AleksaBjelogrlic/glasgow_revD_io_wing/glasgow_revD_io_wing.pdf

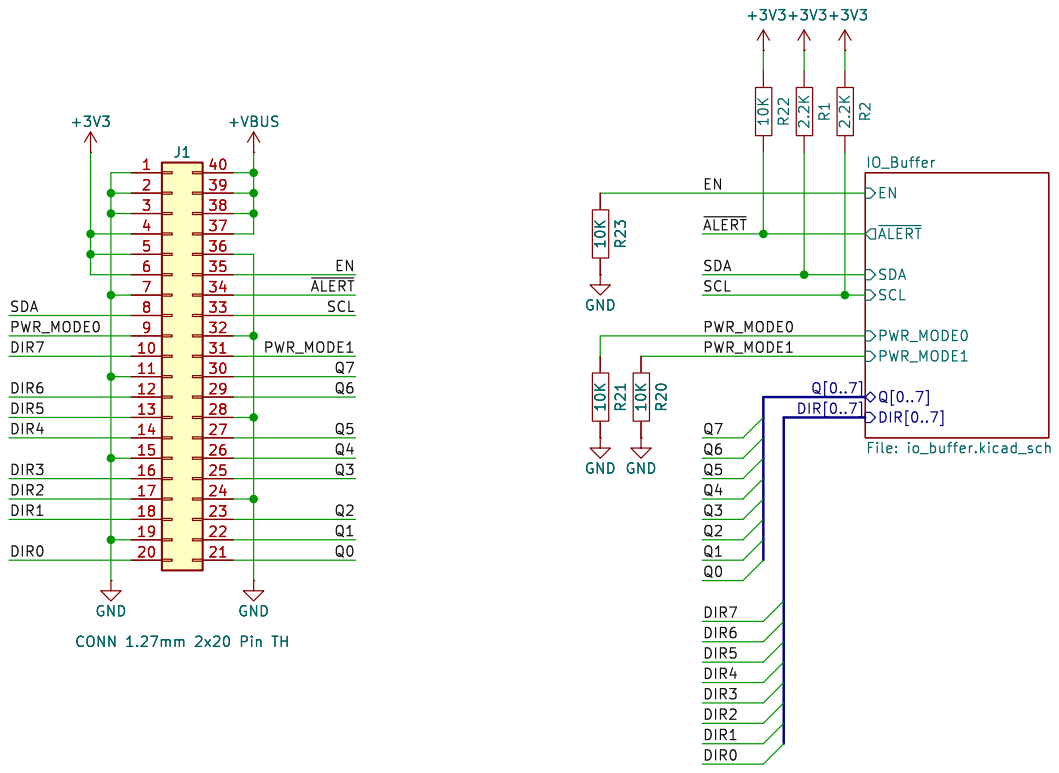
[picture p1: page 1]

2 2 | | 39 39
3 3 | | 38 38
4 4 | | 37 37
5 5 | | 36 36
6 6 | | 35 35 34 34 33 33 32 32

Id: 1/4 Title: File: glasgow_revD_io_wing.kicad_sch Sheet: /

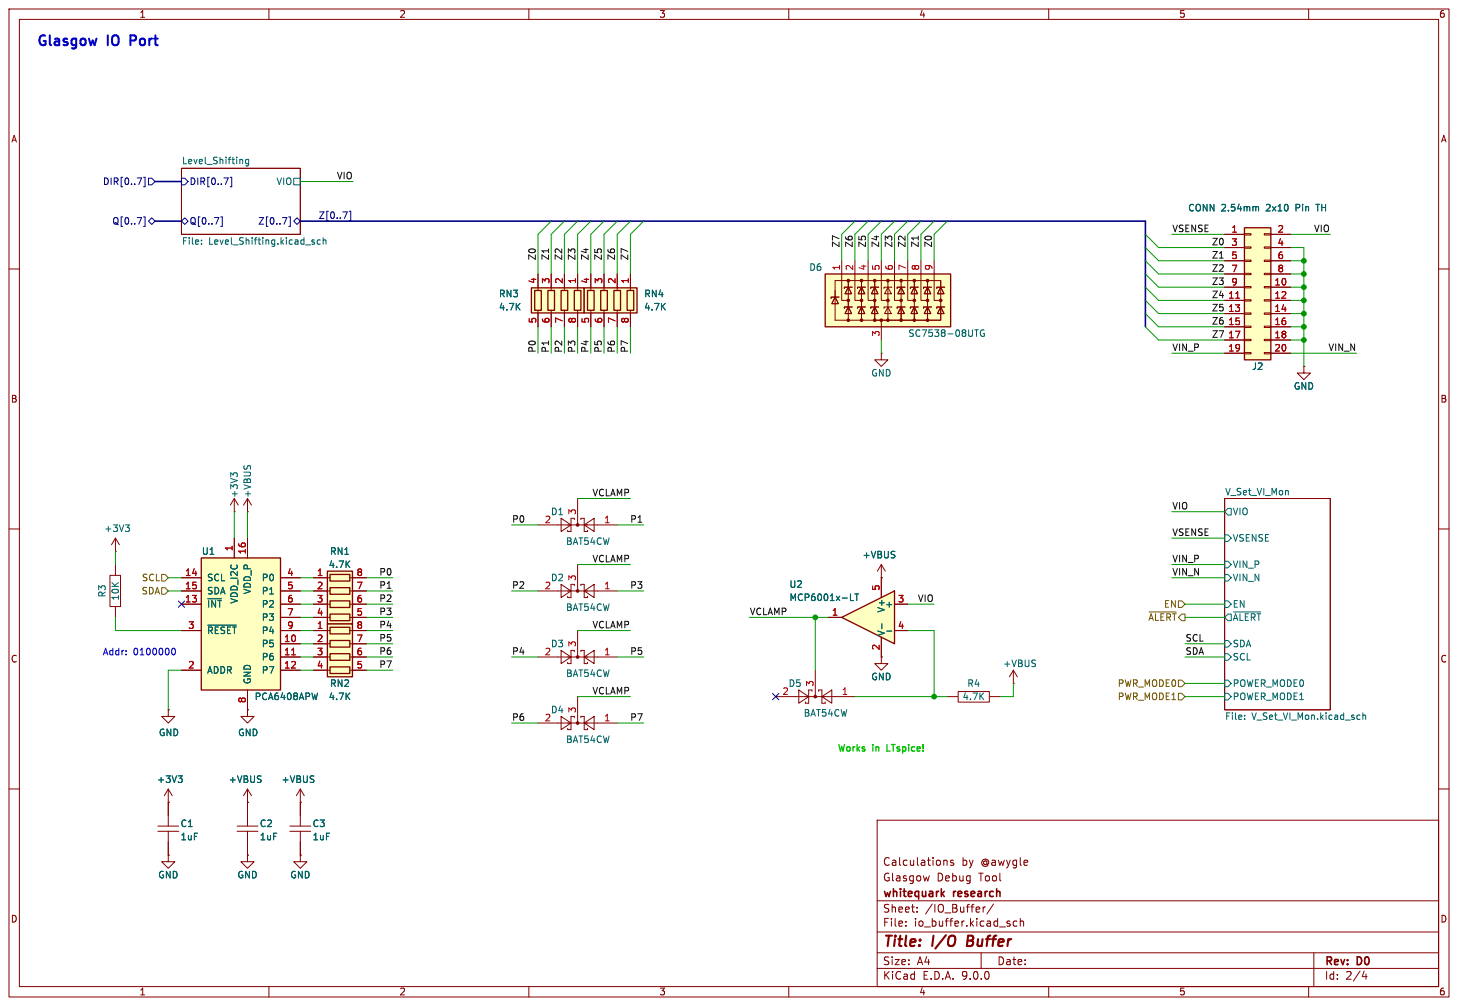
[picture p2: page 2]

Id: 2/4 Title: I/O Buffer File: io_buffer.kicad_sch Sheet: /IO_Buffer/

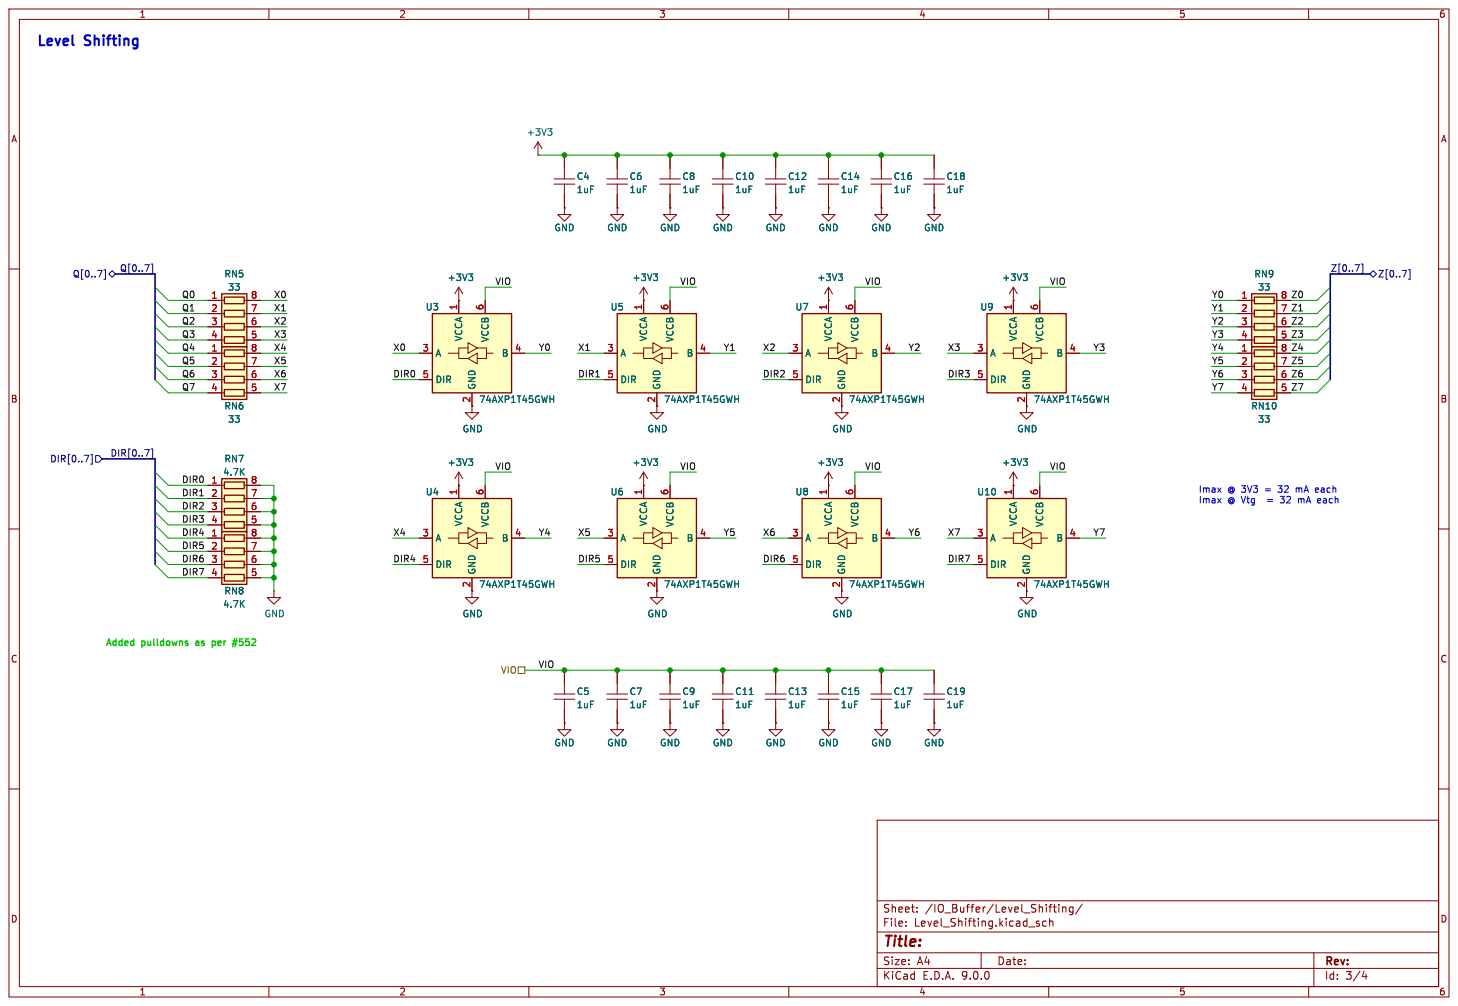
[picture p3: page 3]

Id: 3/4 Title: File: Level_Shifting.kicad_sch Sheet: /IO_Buffer/Level_Shifting/ GND

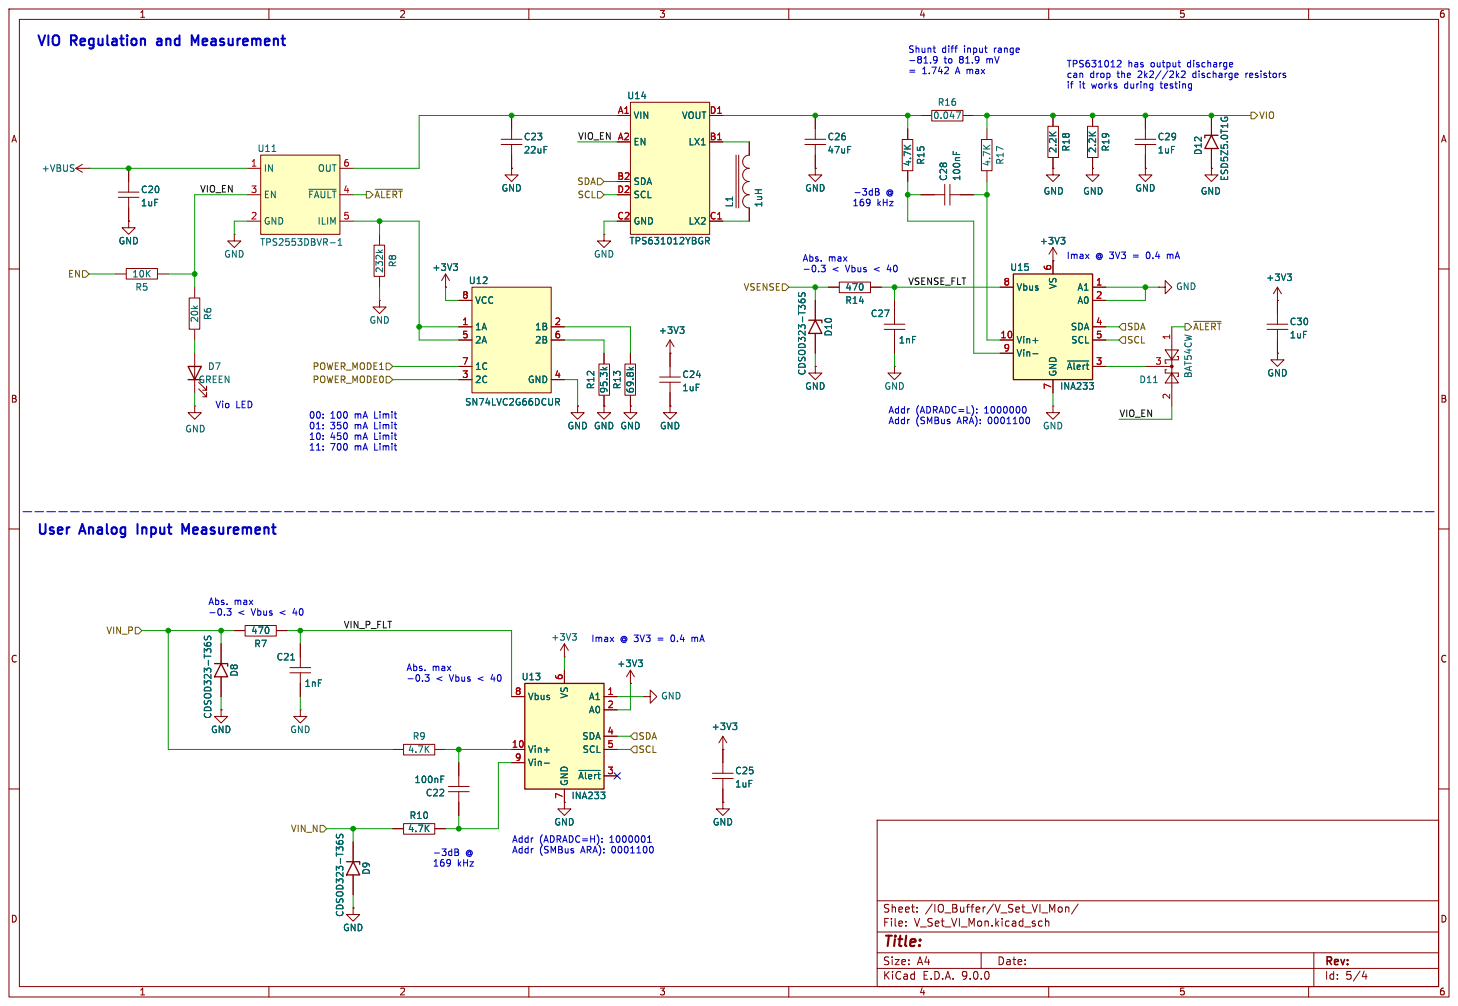
[picture p4: page 4]

169 kHz VIO Regulation and Measurement

if it works during testing Shunt diff input range

7 A1 1 A0 2 SDA 4 SCL 5 ~{Alert}3 R13 69.8k GND

7 A1 1 A0 2 SDA 4 SCL 5 ~{Alert}3 GND D9 CDSOD323-T36S R10

Id: 5/4 Title: File: V_Set_VI_Mon.kicad_sch Sheet: /IO_Buffer/V_Set_VI_Mon/
