AleksaBjelogrlic/glasgow_revD_io_wing/glasgow_revD_io_wing.kicad_pcb

## KiCad design glasgow_revD_io_wing.kicad_pcb (2025-05-19)

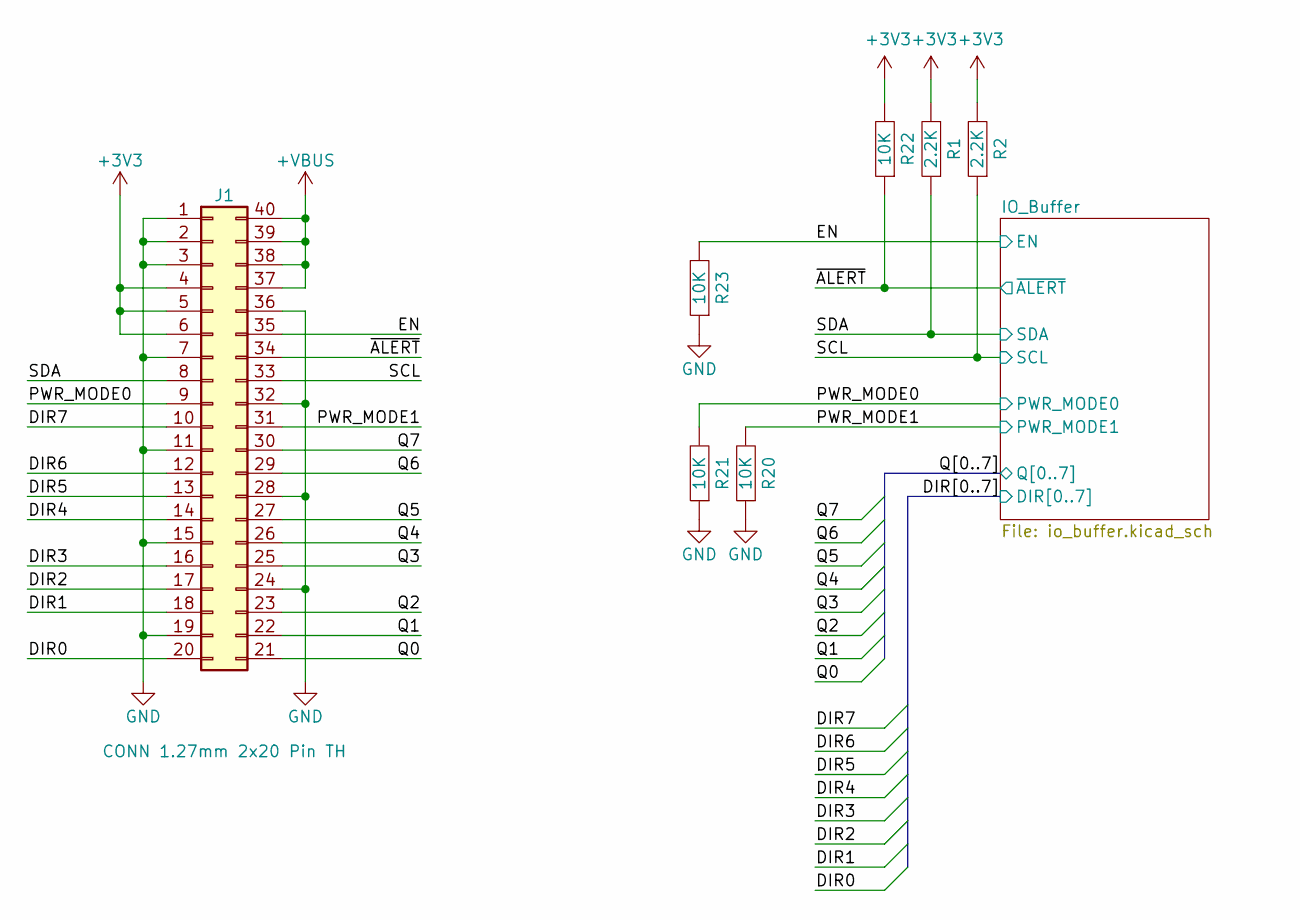
[picture p5: schematic glasgow_revD_io_wing.kicad_sch]

Parts:
J1: CONN 1.27mm 2x20 Pin TH; PinHeader_2x20_P1.27mm_Vertical
R1, R2: 2.2K; GEN_R_0402; TOLERANCE 1%; MANUFACTURER PART NUMBER RC0402FR-132K2L
R20, R21, R22, R23: 10K; GEN_R_0402; TOLERANCE 1%; MANUFACTURER PART NUMBER ERJ-2RKF1002X

Connections:
+3V3: J1.4, J1.5, J1.6, R1.1, R2.1, R22.2; also elsewhere on the board
+VBUS: J1.37, J1.38, J1.39, J1.40; also elsewhere on the board
/DIR0: J1.20; also elsewhere on the board
/DIR1: J1.18; also elsewhere on the board
/DIR2: J1.17; also elsewhere on the board
/DIR3: J1.16; also elsewhere on the board
/DIR4: J1.14; also elsewhere on the board
/DIR5: J1.13; also elsewhere on the board
/DIR6: J1.12; also elsewhere on the board
/DIR7: J1.10; also elsewhere on the board
/EN: J1.35, R23.2; also elsewhere on the board
/PWR_MODE0: J1.9, R21.2; also elsewhere on the board
/PWR_MODE1: J1.31, R20.2; also elsewhere on the board
/Q0: J1.21; also elsewhere on the board
/Q1: J1.22; also elsewhere on the board
/Q2: J1.23; also elsewhere on the board
/Q3: J1.25; also elsewhere on the board
/Q4: J1.26; also elsewhere on the board
/Q5: J1.27; also elsewhere on the board
/Q6: J1.29; also elsewhere on the board
/Q7: J1.30; also elsewhere on the board
/SCL: J1.33, R2.2; also elsewhere on the board
/SDA: J1.8, R1.2; also elsewhere on the board
/~ALERT: J1.34, R22.1; also elsewhere on the board
GND: J1.1, J1.2, J1.3, J1.7, J1.11, J1.15, J1.19, J1.24, J1.28, J1.32, J1.36, R20.1, R21.1, R23.1; also elsewhere on the board

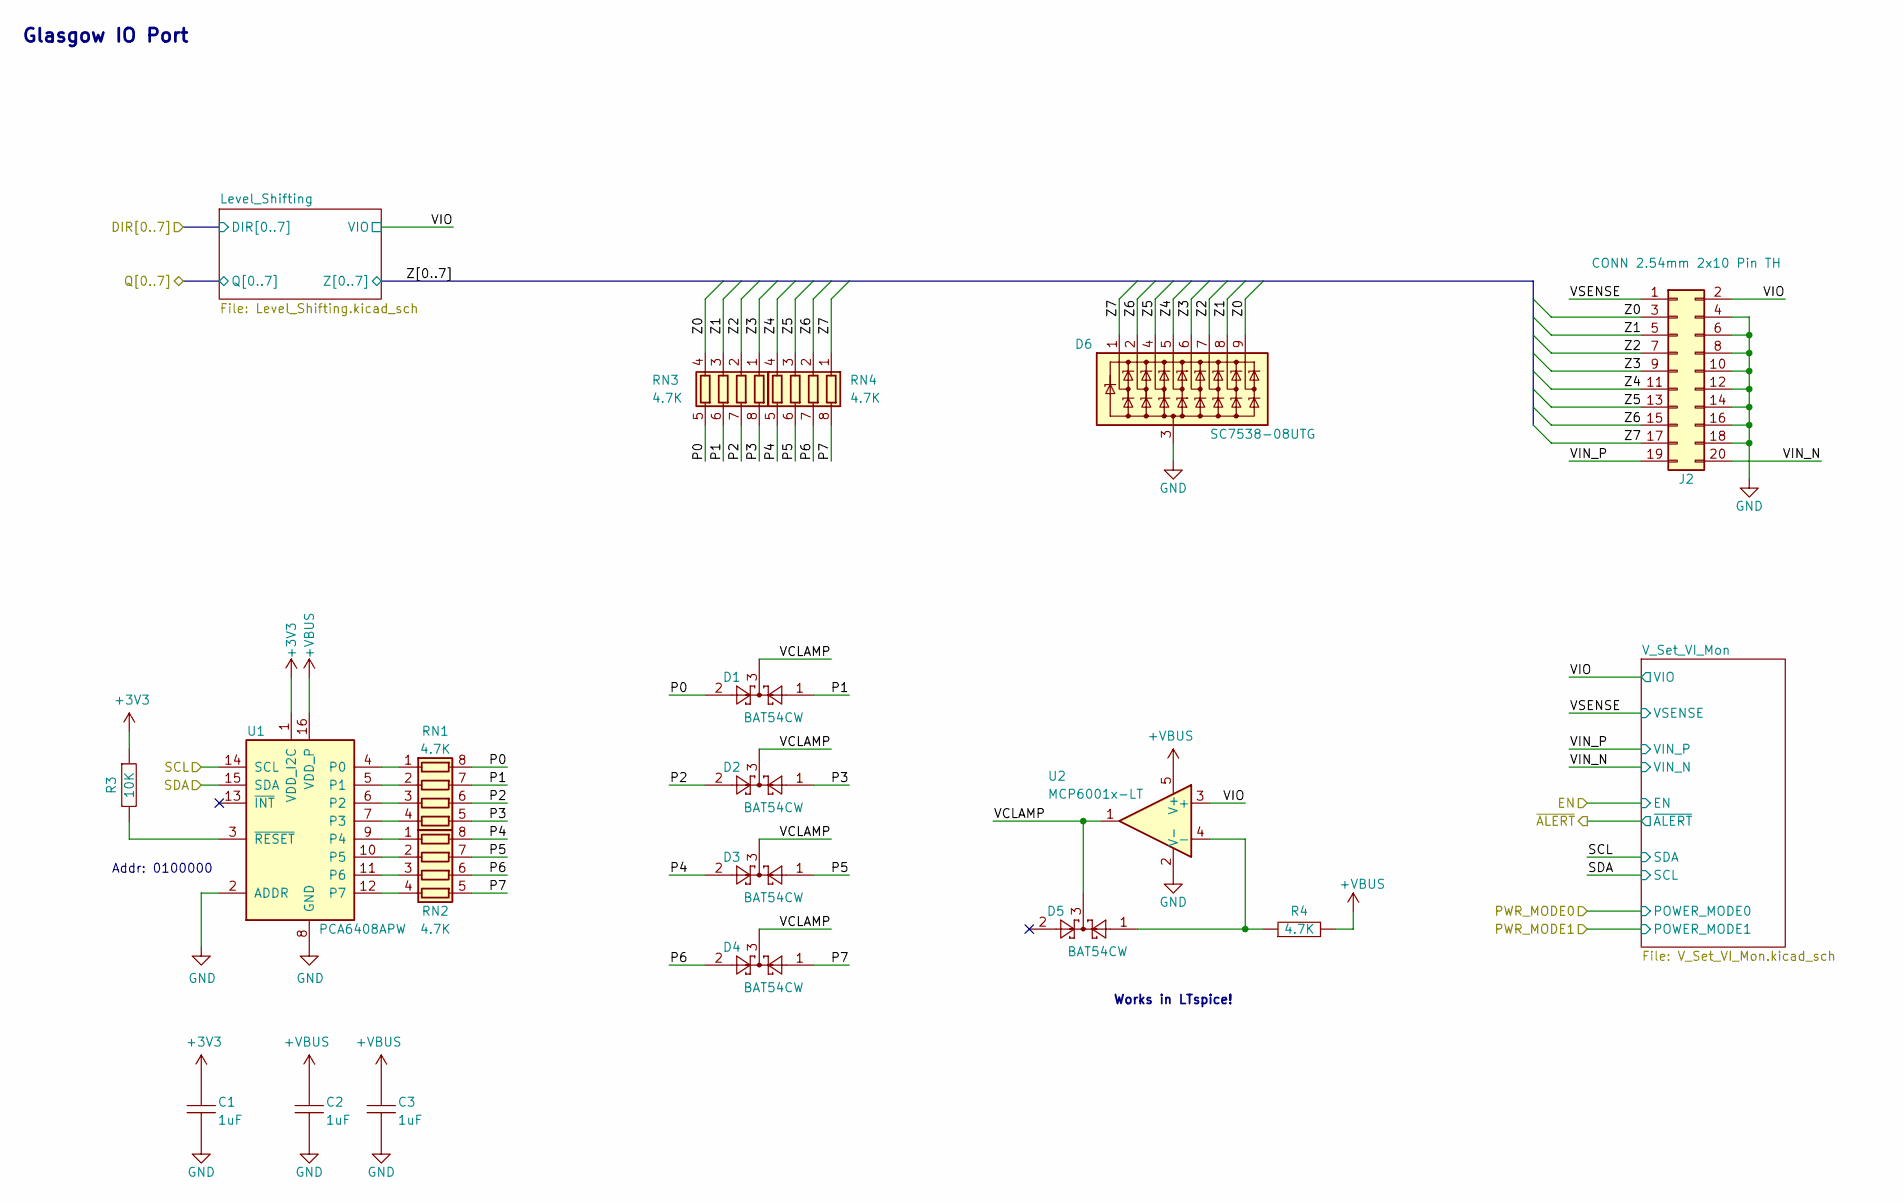
[picture p6: schematic io_buffer.kicad_sch, I/O Buffer]

Parts:
C1, C2, C3: 1uF; GEN_C_0402; VOLTAGE RATING 25V; MANUFACTURER PART NUMBER GRM155R61E105KA12D
D1, D2, D3, D4, D5: BAT54CW; SOT-323_SC-70; MANUFACTURER PART NUMBER BAT54CW-7-F
D6: SC7538-08UTG; Littelfuse_UDFN-9_1.0x3.8mm_P0.5mm; MANUFACTURER PART NUMBER SC7538-08UTG
J2: CONN 2.54mm 2x10 Pin TH; IDC-Header_2x10_P2.54mm_Vertical; MANUFACTURER PART NUMBER 87834-2019
R3: 10K; GEN_R_0402; TOLERANCE 1%; MANUFACTURER PART NUMBER ERJ-2RKF1002X
R4: 4.7K; GEN_R_0402; TOLERANCE 1%; MANUFACTURER PART NUMBER ERJ-2RKF4701X
RN1, RN2, RN3, RN4: 4.7K; R_Array_Convex_4x0402; MANUFACTURER PART NUMBER YC124-FR-074K7L
U1: PCA6408APW; TSSOP-16_4.4x5mm_P0.65mm; MANUFACTURER PART NUMBER PCA6408APW
U2: MCP6001x-LT; SOT-353_SC-70-5; MANUFACTURER PART NUMBER MCP6001T-I/LT

Connections:
+3V3: C1.1, R3.1, U1.1 (VDD_I2C); also elsewhere on the board
+VBUS: C2.1, C3.1, R4.1, U1.16 (VDD_P), U2.5 (V+); also elsewhere on the board
/IO_Buffer/P0: D1.2, RN1.8 (R1.2), RN3.5 (R4.2)
/IO_Buffer/P1: D1.1, RN1.7 (R2.2), RN3.6 (R3.2)
/IO_Buffer/P2: D2.2, RN1.6 (R3.2), RN3.7 (R2.2)
/IO_Buffer/P3: D2.1, RN1.5 (R4.2), RN3.8 (R1.2)
/IO_Buffer/P4: D3.2, RN2.8 (R1.2), RN4.5 (R4.2)
/IO_Buffer/P5: D3.1, RN2.7 (R2.2), RN4.6 (R3.2)
/IO_Buffer/P6: D4.2, RN2.6 (R3.2), RN4.7 (R2.2)
/IO_Buffer/P7: D4.1, RN2.5 (R4.2), RN4.8 (R1.2)
/IO_Buffer/VCLAMP: D1.3, D2.3, D3.3, D4.3, D5.3, U2.1
/IO_Buffer/VIN_N: J2.20; also elsewhere on the board
/IO_Buffer/VIN_P: J2.19; also elsewhere on the board
/IO_Buffer/VIO: J2.2, U2.3 (+); also elsewhere on the board
/IO_Buffer/VSENSE: J2.1; also elsewhere on the board
/IO_Buffer/Z0: D6.9 (K8), J2.3, RN3.4 (R4.1); also elsewhere on the board
/IO_Buffer/Z1: D6.8 (K7), J2.5, RN3.3 (R3.1); also elsewhere on the board
/IO_Buffer/Z2: D6.7 (K6), J2.7, RN3.2 (R2.1); also elsewhere on the board
/IO_Buffer/Z3: D6.6 (K5), J2.9, RN3.1 (R1.1); also elsewhere on the board
/IO_Buffer/Z4: D6.5 (K4), J2.11, RN4.4 (R4.1); also elsewhere on the board
/IO_Buffer/Z5: D6.4 (K3), J2.13, RN4.3 (R3.1); also elsewhere on the board
/IO_Buffer/Z6: D6.2 (K2), J2.15, RN4.2 (R2.1); also elsewhere on the board
/IO_Buffer/Z7: D6.1 (K1), J2.17, RN4.1 (R1.1); also elsewhere on the board
/SCL: U1.14 (SCL); also elsewhere on the board
/SDA: U1.15 (SDA); also elsewhere on the board
GND: C1.2, C2.2, C3.2, D6.3 (A), J2.4, J2.6, J2.8, J2.10, J2.12, J2.14, J2.16, J2.18, U1.2 (ADDR), U1.8 (GND), U2.2 (V-); also elsewhere on the board
unnamed: RN1.1 (R1.1), U1.4 (P0)
unnamed: RN1.2 (R2.1), U1.5 (P1)
unnamed: RN1.3 (R3.1), U1.6 (P2)
unnamed: RN1.4 (R4.1), U1.7 (P3)
unnamed: RN2.1 (R1.1), U1.9 (P4)
unnamed: RN2.2 (R2.1), U1.10 (P5)
unnamed: RN2.3 (R3.1), U1.11 (P6)
unnamed: RN2.4 (R4.1), U1.12 (P7)
unnamed: R3.2, U1.3 (~RESET)
unnamed: D5.1, R4.2, U2.4 (-)

Notes on the sheet:
Glasgow IO Port
Addr: 0100000
Works in LTspice!

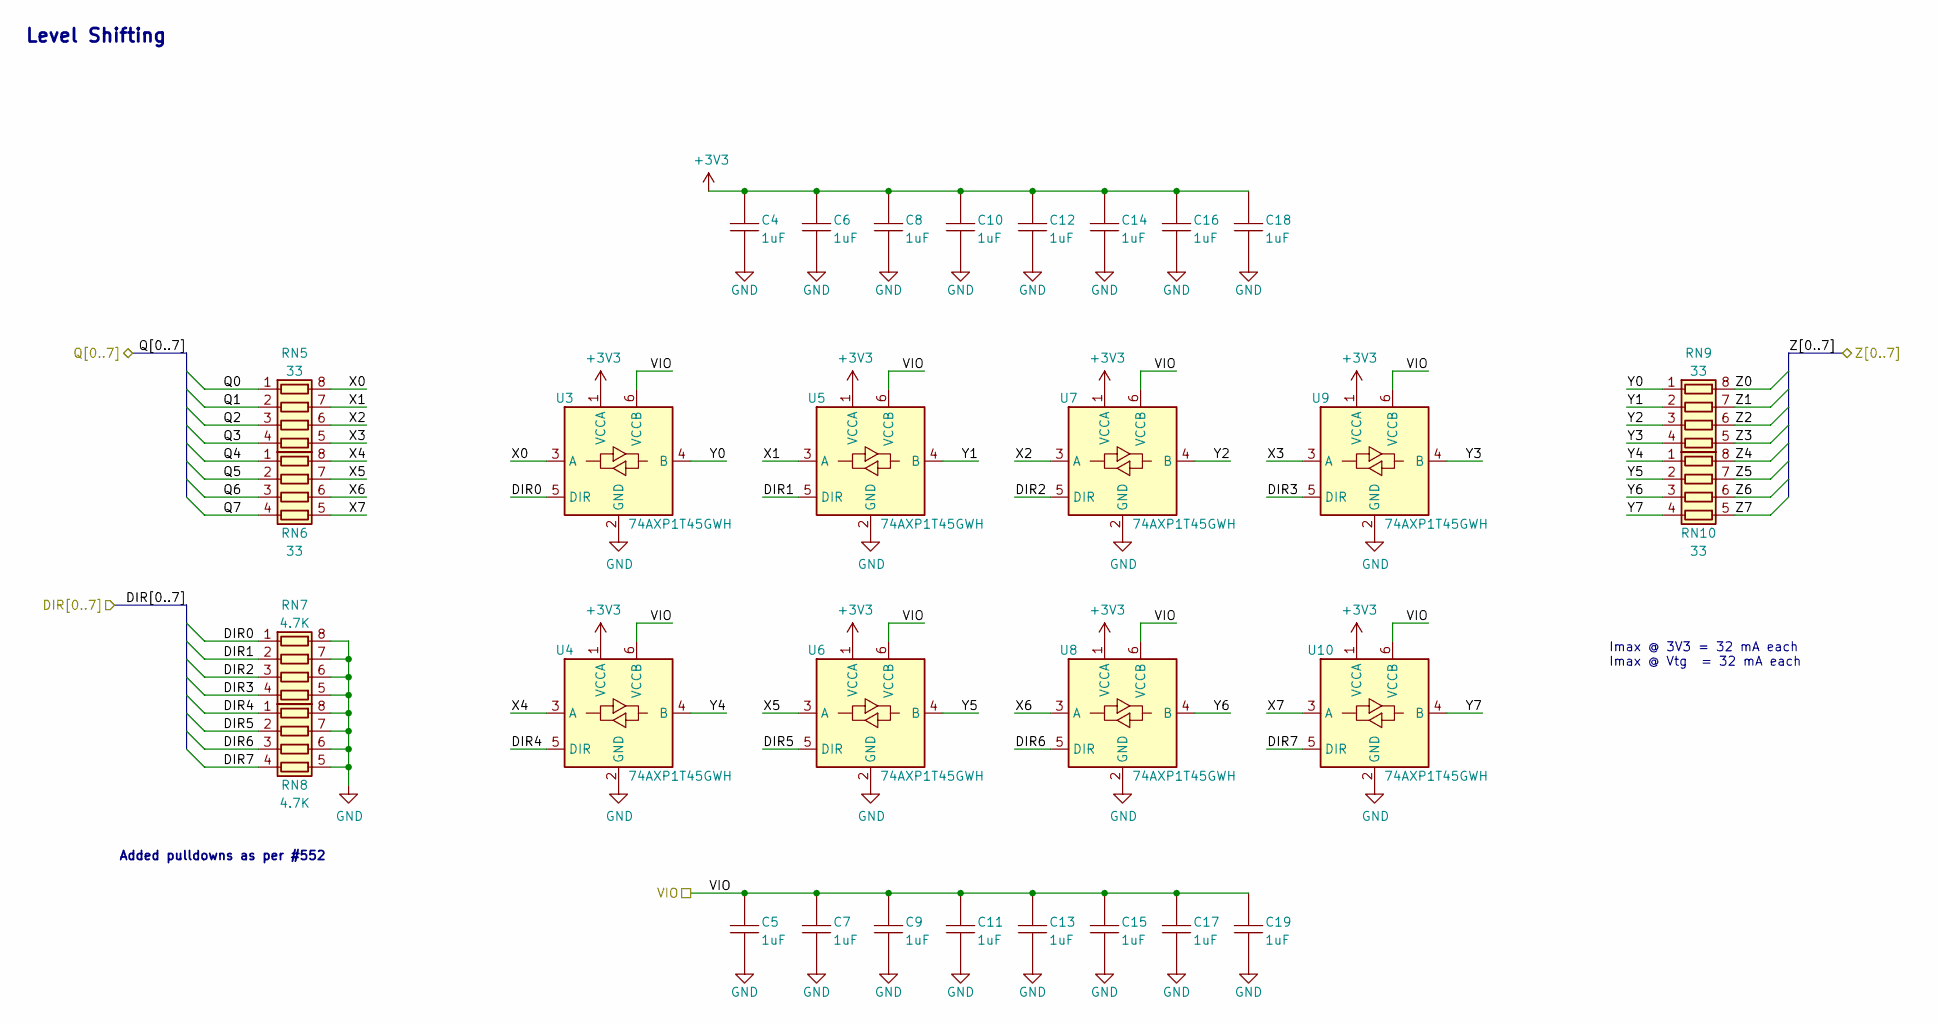
[picture p7: schematic Level_Shifting.kicad_sch]

Parts:
C4, C5, C6, C7, C8, C9, C10, C11, C12, C13, C14, C15, C16, C17, C18, C19: 1uF; GEN_C_0402; VOLTAGE RATING 25V; MANUFACTURER PART NUMBER GRM155R61E105KA12D
RN5, RN6, RN9, RN10: 33; R_Array_Convex_4x0402; MANUFACTURER PART NUMBER YC124-JR-1333RL
RN7, RN8: 4.7K; R_Array_Convex_4x0402; MANUFACTURER PART NUMBER YC124-FR-074K7L
U3, U4, U5, U6, U7, U8, U9, U10: 74AXP1T45GWH; SOT-363_SC-70-6; MANUFACTURER PART NUMBER 74AXP1T45GWH

Connections:
+3V3: C4.1, C6.1, C8.1, C10.1, C12.1, C14.1, C16.1, C18.1, U3.1 (VCCA), U4.1 (VCCA), U5.1 (VCCA), U6.1 (VCCA), U7.1 (VCCA), U8.1 (VCCA), U9.1 (VCCA), U10.1 (VCCA); also elsewhere on the board
/DIR0: RN7.1 (R1.1), U3.5 (DIR); also elsewhere on the board
/DIR1: RN7.2 (R2.1), U5.5 (DIR); also elsewhere on the board
/DIR2: RN7.3 (R3.1), U7.5 (DIR); also elsewhere on the board
/DIR3: RN7.4 (R4.1), U9.5 (DIR); also elsewhere on the board
/DIR4: RN8.1 (R1.1), U4.5 (DIR); also elsewhere on the board
/DIR5: RN8.2 (R2.1), U6.5 (DIR); also elsewhere on the board
/DIR6: RN8.3 (R3.1), U8.5 (DIR); also elsewhere on the board
/DIR7: RN8.4 (R4.1), U10.5 (DIR); also elsewhere on the board
/IO_Buffer/Level_Shifting/X0: RN5.8 (R1.2), U3.3 (A)
/IO_Buffer/Level_Shifting/X1: RN5.7 (R2.2), U5.3 (A)
/IO_Buffer/Level_Shifting/X2: RN5.6 (R3.2), U7.3 (A)
/IO_Buffer/Level_Shifting/X3: RN5.5 (R4.2), U9.3 (A)
/IO_Buffer/Level_Shifting/X4: RN6.8 (R1.2), U4.3 (A)
/IO_Buffer/Level_Shifting/X5: RN6.7 (R2.2), U6.3 (A)
/IO_Buffer/Level_Shifting/X6: RN6.6 (R3.2), U8.3 (A)
/IO_Buffer/Level_Shifting/X7: RN6.5 (R4.2), U10.3 (A)
/IO_Buffer/Level_Shifting/Y0: RN9.1 (R1.1), U3.4 (B)
/IO_Buffer/Level_Shifting/Y1: RN9.2 (R2.1), U5.4 (B)
/IO_Buffer/Level_Shifting/Y2: RN9.3 (R3.1), U7.4 (B)
/IO_Buffer/Level_Shifting/Y3: RN9.4 (R4.1), U9.4 (B)
/IO_Buffer/Level_Shifting/Y4: RN10.1 (R1.1), U4.4 (B)
/IO_Buffer/Level_Shifting/Y5: RN10.2 (R2.1), U6.4 (B)
/IO_Buffer/Level_Shifting/Y6: RN10.3 (R3.1), U8.4 (B)
/IO_Buffer/Level_Shifting/Y7: RN10.4 (R4.1), U10.4 (B)
/IO_Buffer/VIO: C5.1, C7.1, C9.1, C11.1, C13.1, C15.1, C17.1, C19.1, U3.6 (VCCB), U4.6 (VCCB), U5.6 (VCCB), U6.6 (VCCB), U7.6 (VCCB), U8.6 (VCCB), U9.6 (VCCB), U10.6 (VCCB); also elsewhere on the board
/IO_Buffer/Z0: RN9.8 (R1.2); also elsewhere on the board
/IO_Buffer/Z1: RN9.7 (R2.2); also elsewhere on the board
/IO_Buffer/Z2: RN9.6 (R3.2); also elsewhere on the board
/IO_Buffer/Z3: RN9.5 (R4.2); also elsewhere on the board
/IO_Buffer/Z4: RN10.8 (R1.2); also elsewhere on the board
/IO_Buffer/Z5: RN10.7 (R2.2); also elsewhere on the board
/IO_Buffer/Z6: RN10.6 (R3.2); also elsewhere on the board
/IO_Buffer/Z7: RN10.5 (R4.2); also elsewhere on the board
/Q0: RN5.1 (R1.1); also elsewhere on the board
/Q1: RN5.2 (R2.1); also elsewhere on the board
/Q2: RN5.3 (R3.1); also elsewhere on the board
/Q3: RN5.4 (R4.1); also elsewhere on the board
/Q4: RN6.1 (R1.1); also elsewhere on the board
/Q5: RN6.2 (R2.1); also elsewhere on the board
/Q6: RN6.3 (R3.1); also elsewhere on the board
/Q7: RN6.4 (R4.1); also elsewhere on the board
GND: C4.2, C5.2, C6.2, C7.2, C8.2, C9.2, C10.2, C11.2, C12.2, C13.2, C14.2, C15.2, C16.2, C17.2, C18.2, C19.2, RN7.5 (R4.2), RN7.6 (R3.2), RN7.7 (R2.2), RN7.8 (R1.2), RN8.5 (R4.2), RN8.6 (R3.2), RN8.7 (R2.2), RN8.8 (R1.2), U3.2 (GND), U4.2 (GND), U5.2 (GND), U6.2 (GND), U7.2 (GND), U8.2 (GND), U9.2 (GND), U10.2 (GND); also elsewhere on the board

Notes on the sheet:
Imax @ 3V3 = 32 mA each Imax @ Vtg = 32 mA each
Added pulldowns as per #552
Level Shifting

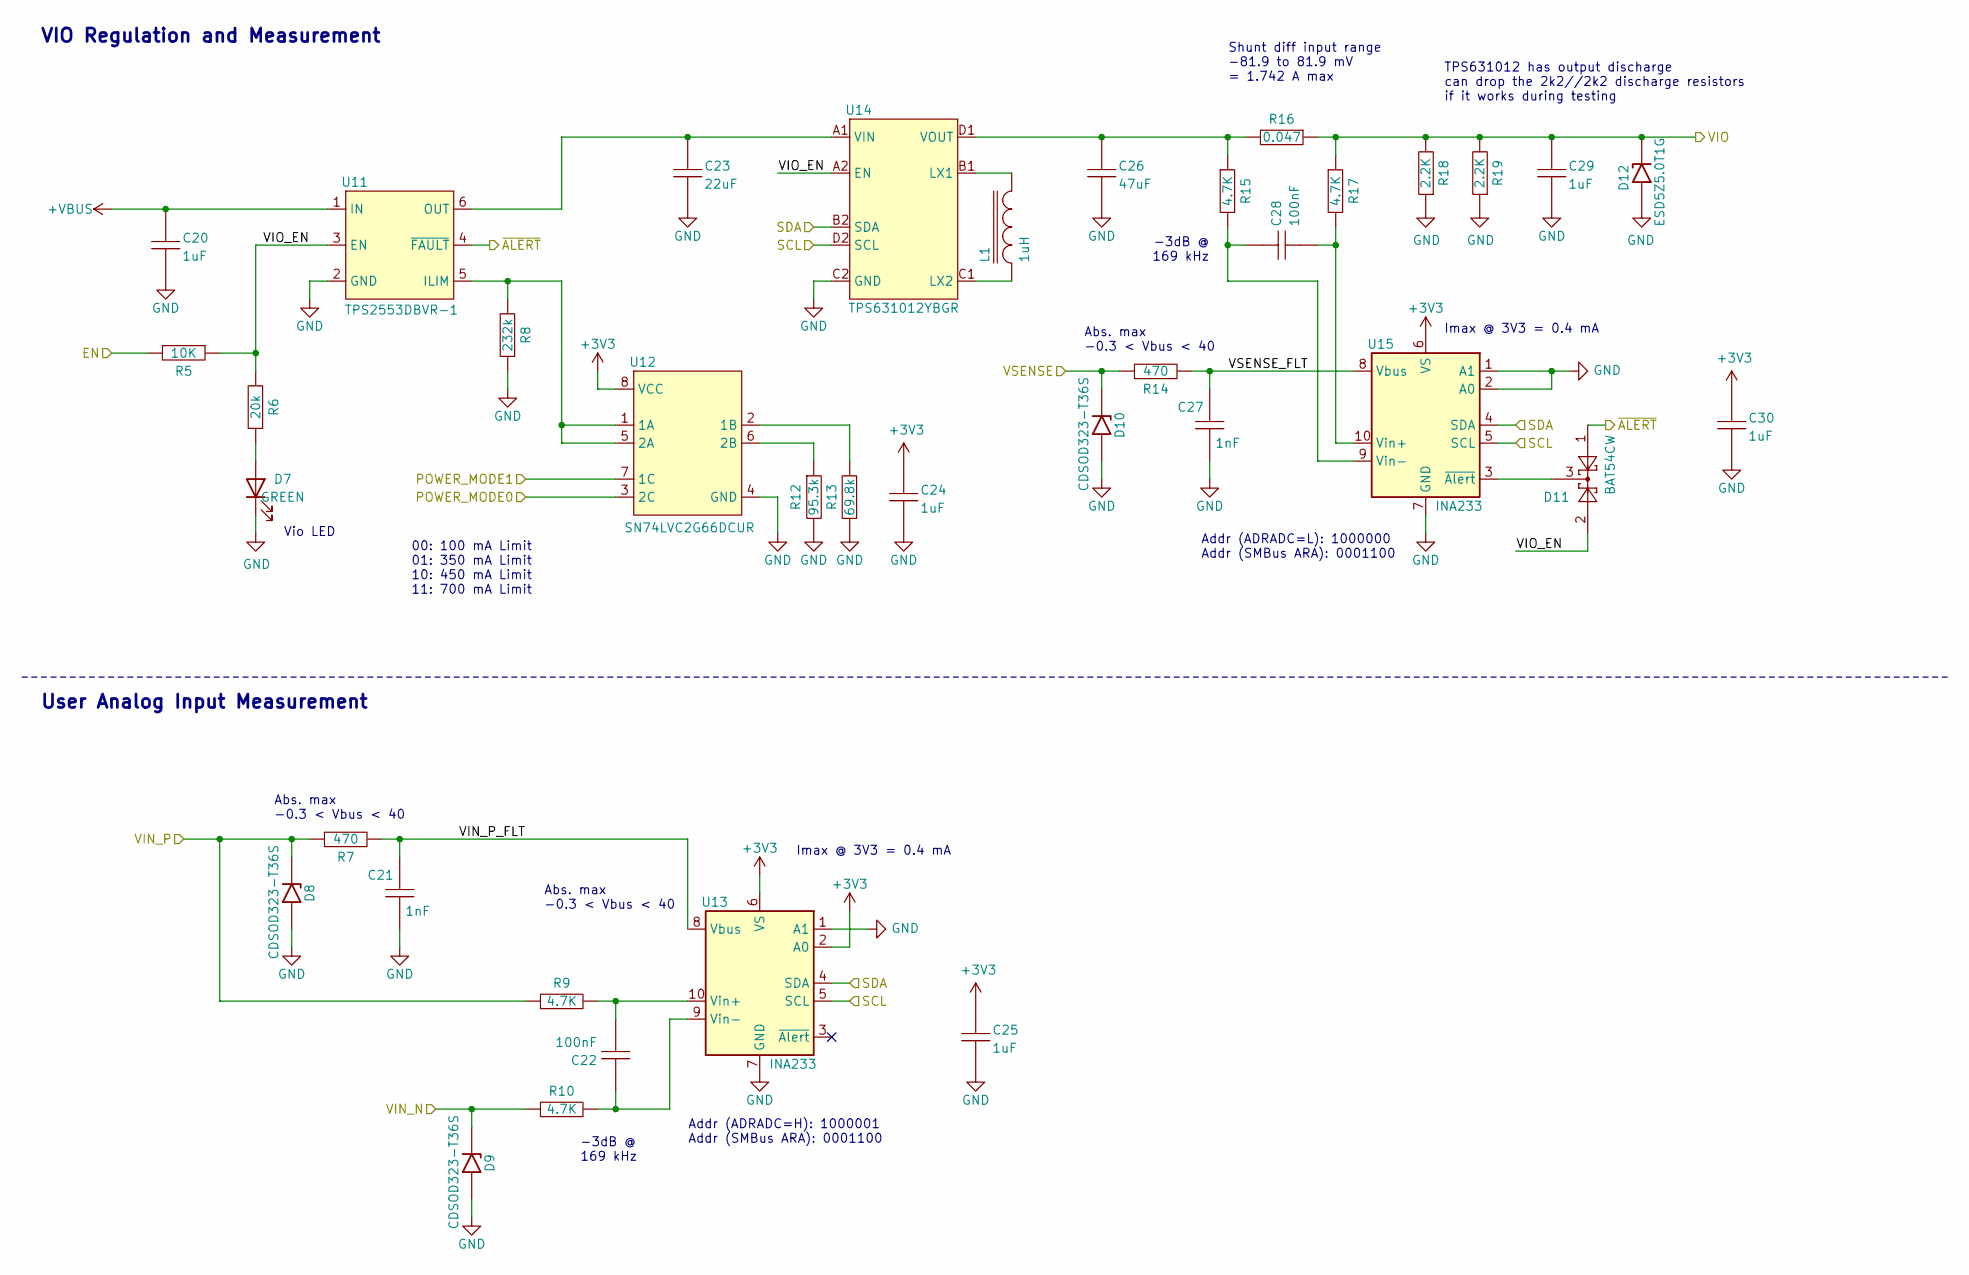
[picture p8: schematic V_Set_VI_Mon.kicad_sch]

Parts:
C20, C24, C25, C29, C30: 1uF; GEN_C_0402; VOLTAGE RATING 25V; MANUFACTURER PART NUMBER GRM155R61E105KA12D
C21, C27: 1nF; GEN_C_0402; VOLTAGE RATING 50V; MANUFACTURER PART NUMBER GRM1555C1H102FA01D
C22, C28: 100nF; GEN_C_0402; VOLTAGE RATING 16V; MANUFACTURER PART NUMBER GCM155R71C104KA55D
C23: 22uF; GEN_C_0805; VOLTAGE RATING 25V; MANUFACTURER PART NUMBER GRM21BR61E226ME44L
C26: 47uF; GEN_C_0805; VOLTAGE RATING 6.3V; MANUFACTURER PART NUMBER CL21A476MQYNNNE
D7: GREEN; LED_0603_1608Metric; MANUFACTURER PART NUMBER NCD0603G1
D8, D9, D10: CDSOD323-T36S; D_SOD-323; MANUFACTURER PART NUMBER CDSOD323-T36S
D11: BAT54CW; SOT-323_SC-70; MANUFACTURER PART NUMBER BAT54CW-7-F
D12: ESD5Z5.0T1G; D_SOD-323; MANUFACTURER PART NUMBER ESD5Z5.0T1G
L1: 1uH; GEN_L_1210; MANUFACTURER PART NUMBER SRP3212-1R0M
R5: 10K; GEN_R_0402; TOLERANCE 1%; MANUFACTURER PART NUMBER ERJ-2RKF1002X
R6: 20k; GEN_R_0402; TOLERANCE 1%; MANUFACTURER PART NUMBER RC0402FR-0720KL
R7, R14: 470; GEN_R_0402; TOLERANCE 1%; MANUFACTURER PART NUMBER RC0402FR-07470RL
R8: 232k; GEN_R_0402; TOLERANCE 1%; MANUFACTURER PART NUMBER RC0402FR-13232KL
R9, R10, R15, R17: 4.7K; GEN_R_0402; TOLERANCE 1%; MANUFACTURER PART NUMBER ERJ-2RKF4701X
R12: 95.3k; GEN_R_0402; TOLERANCE 1%; MANUFACTURER PART NUMBER RC0402FR-0795K3L
R13: 69.8k; GEN_R_0402; TOLERANCE 1%; MANUFACTURER PART NUMBER RC0402FR-0769K8L
R16: 0.047; GEN_R_0603; TOLERANCE 1%; MANUFACTURER PART NUMBER RL0816T-R047-F
R18, R19: 2.2K; GEN_R_0402; TOLERANCE 1%; MANUFACTURER PART NUMBER RC0402FR-132K2L
U11: TPS2553DBVR-1; SOT-23-6; MANUFACTURER PART NUMBER TPS2553DBVR-1
U12: SN74LVC2G66DCUR; Texas_VSSOP-8_2x3.1mm_P0.9; MANUFACTURER PART NUMBER SN74LVC2G66DCUR
U13, U15: INA233; VSSOP-10_3x3mm_P0.5mm; MANUFACTURER PART NUMBER INA233AIDGSR
U14: TPS631012YBGR; Texas_DSBGA-8_0.9x1.9mm_Layout2x4_P0.5mm; MANUFACTURER PART NUMBER TPS631012YBGR

Connections:
+3V3: C24.1, C25.1, C30.1, U12.8 (VCC), U13.2 (A0), U13.6 (VS), U15.6 (VS); also elsewhere on the board
+VBUS: C20.1, U11.1 (IN); also elsewhere on the board
/EN: R5.2; also elsewhere on the board
/IO_Buffer/VIN_N: D9.1 (K), R10.2; also elsewhere on the board
/IO_Buffer/VIN_P: D8.1 (K), R7.2, R9.2; also elsewhere on the board
/IO_Buffer/VIO: C29.1, D12.1 (K), R16.2, R17.2, R18.1, R19.1; also elsewhere on the board
/IO_Buffer/VSENSE: D10.1 (K), R14.2; also elsewhere on the board
/IO_Buffer/V_Set_VI_Mon/VIN_P_FLT: C21.1, R7.1, U13.8 (Vbus)
/IO_Buffer/V_Set_VI_Mon/VIO_EN: D11.2, R5.1, R6.1, U11.3 (EN), U14.A2 (EN)
/IO_Buffer/V_Set_VI_Mon/VSENSE_FLT: C27.1, R14.1, U15.8 (Vbus)
/PWR_MODE0: U12.3 (2C); also elsewhere on the board
/PWR_MODE1: U12.7 (1C); also elsewhere on the board
/SCL: U13.4 (SDA), U14.B2 (SDA), U15.4 (SDA); also elsewhere on the board
/SDA: U13.5 (SCL), U14.D2 (SCL), U15.5 (SCL); also elsewhere on the board
/~ALERT: D11.1, U11.4 (~FAULT); also elsewhere on the board
GND: C20.2, C21.2, C23.1, C24.2, C25.2, C26.1, C27.2, C29.2, C30.2, D7.1 (K), D8.2 (A), D9.2 (A), D10.2 (A), D12.2 (A), R8.2, R12.1, R13.2, R18.2, R19.2, U11.2 (GND), U12.4 (GND), U13.1 (A1), U13.7 (GND), U14.C2 (GND), U15.1 (A1), U15.2 (A0), U15.7 (GND); also elsewhere on the board
unnamed: D7.2 (A), R6.2
unnamed: R8.1, U11.5 (ILIM), U12.1 (1A), U12.5 (2A)
unnamed: C23.2, U11.6 (OUT), U14.A1 (VIN)
unnamed: R13.1, U12.2 (1B)
unnamed: R12.2, U12.6 (2B)
unnamed: C22.1, R9.1, U13.10 (Vin+)
unnamed: C22.2, R10.1, U13.9 (Vin-)
unnamed: L1.2, U14.B1 (LX1)
unnamed: L1.1, U14.C1 (LX2)
unnamed: C26.2, R15.2, R16.1, U14.D1 (VOUT)
unnamed: C28.1, R17.1, U15.10 (Vin+)
unnamed: C28.2, R15.1, U15.9 (Vin-)
unnamed: D11.3, U15.3 (~Alert)

Notes on the sheet:
Shunt diff input range -81.9 to 81.9 mV = 1.742 A max
Addr (ADRADC=H): 1000001 Addr (SMBus ARA): 0001100
Addr (ADRADC=L): 1000000 Addr (SMBus ARA): 0001100
TPS631012 has output discharge can drop the 2k2//2k2 discharge resistors if it works during testing
Abs. max -0.3 < Vbus < 40
00: 100 mA Limit 01: 350 mA Limit 10: 450 mA Limit 11: 700 mA Limit
Imax @ 3V3 = 0.4 mA
VIO Regulation and Measurement
Vio LED
-3dB @ 169 kHz
User Analog Input Measurement

Board: 2 copper layers, 92 parts (0 on the bottom side), 88 nets, no tracks yet.
